YXNi/JILA_eEDM_Magnetometer/Appendix_assemble/BOM.pdf

Description | QTY | Ref Des | Mfg P/N #
CAP CER 0.22UF 25V 10% X7R 0805 | | 1 C3 | VJ0805Y224KNXAT
CAP CER 0.1UF 50V 10% X7R 0805 | | 1 C2 | VJ0805Y104KNAAT
CAP CER 0.47UF 25V 20% Y5V 0805 | | 1 C1 | VJ0805V474MXXCW1BC
IC COMPASS 3 AXIS I2C 16LCC SMD | | 1 MAG1 | HMC5883L-TR

Distributor | Distributor P/N #
Digi-key | 720-1247-2-ND
Digi-key | 720-1245-2-ND
Digi-key | 720-1389-1-ND
Digi-key | 342-1082-1-ND
