YXNi/JILA_eEDM_Magnetometer/Appendix_hardware/MagPCB/MagPCB/SensorPCB/BOM.xlsx

Best Practice Bill of Materials (BOM) Template
1. Reference Designators - Place all designators with the same part number in one cell
2. Description Value Package - Advanced Assembly's system perfers this to be combined into one cell
3. Alternate Part Numbers - Place in additional columns to the right on the same line
4. Do Not Install (DNI) Parts - Indicate quantity zero and/or add DNI column
5. Notes - Place in additional column on the same line
6. Refrain from using merged cells
*Please contact your account executive with any questions.*
 |  |  |  | êAuto-populates as you fill in the previous cellsê
Mfg Part # | Description | Value | Pkg | Description Value Pkg *AAPCB Format* | Ref. Des. | Qty | DNI | Notes | Mfg (Optional) | Vendor (Optional) | Vendor Part # (Optional) | Alternate Mfg Part # (Optional) | Type (Optional)
VJ0805Y224KNXAT | CAP | .22uF@25V | 805 | CAP .22uF@25V 805 | C3 | 1 |  |  | Vishay
VJ0805Y104KNAAT | CAP | 0.1UF 25V 10% | 805 | CAP 0.1UF 25V 10% 805 | C2 | 1 |  |  | Vishay
HMC5883L-TR | Magnetic censor |  | 16LCC SMD | Magnetic censor 16LCC SMD | MAG1 | 1 |  |  | Honeywell | Digi-Key | 342-1082-1-ND
UMK325F475ZH-T | CAP | 4.7uF@50V 10% | 1210 | CAP 4.7uF@50V 10% 1210 | C1 | 1 |  |  | Taiyo-yuden | Digi-Key | 587-1389-1-ND
