YXNi/JILA_eEDM_Magnetometer/Appendix_assemble/CPL.pdf

Ref Designator | Mid X(mm) Mid Y(mm) Layer Rotation
C1 | 0 | 12 top | 0
C2 | -5 | 12 top | 180
C3 | 5 | 12 top | 0
MAG1 | 0 | 0 top | 0
