YXNi/JILA_eEDM_Magnetometer/Appendix_hardware/MagPCB_ChipMount.pdf

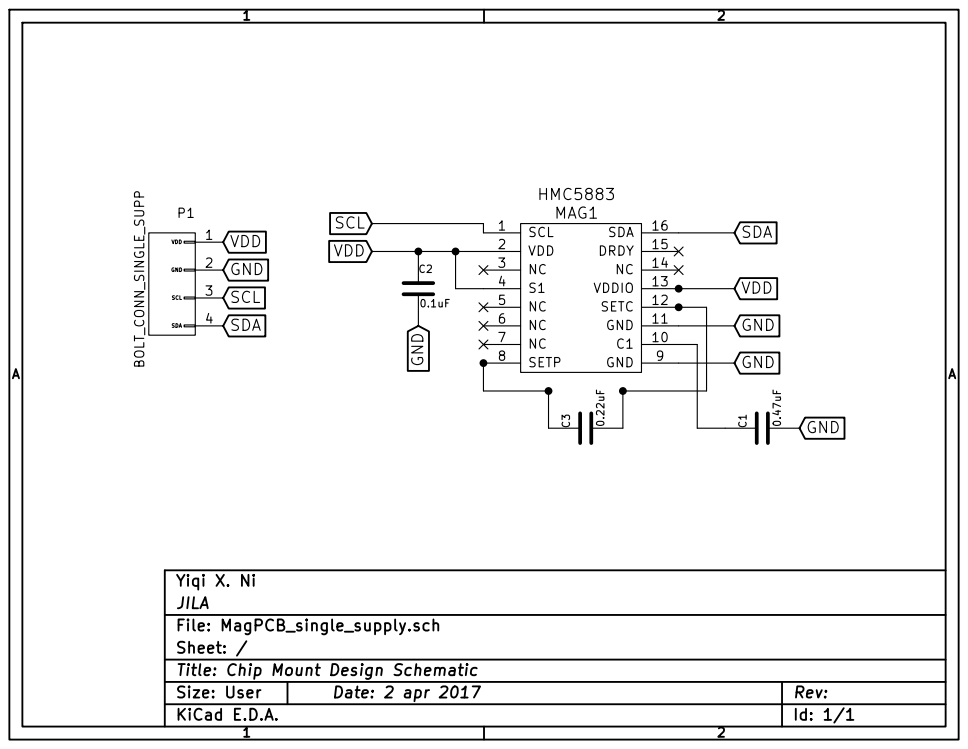
[picture p4: page 1]

Title: Chip Mount Design Schematic

Size: User | | Rev:
KiCad E.D.A. | | Id: 1/1
