YXNi/JILA_eEDM_Magnetometer/Appendix_hardware/MagPCB_Gradiometer.pdf

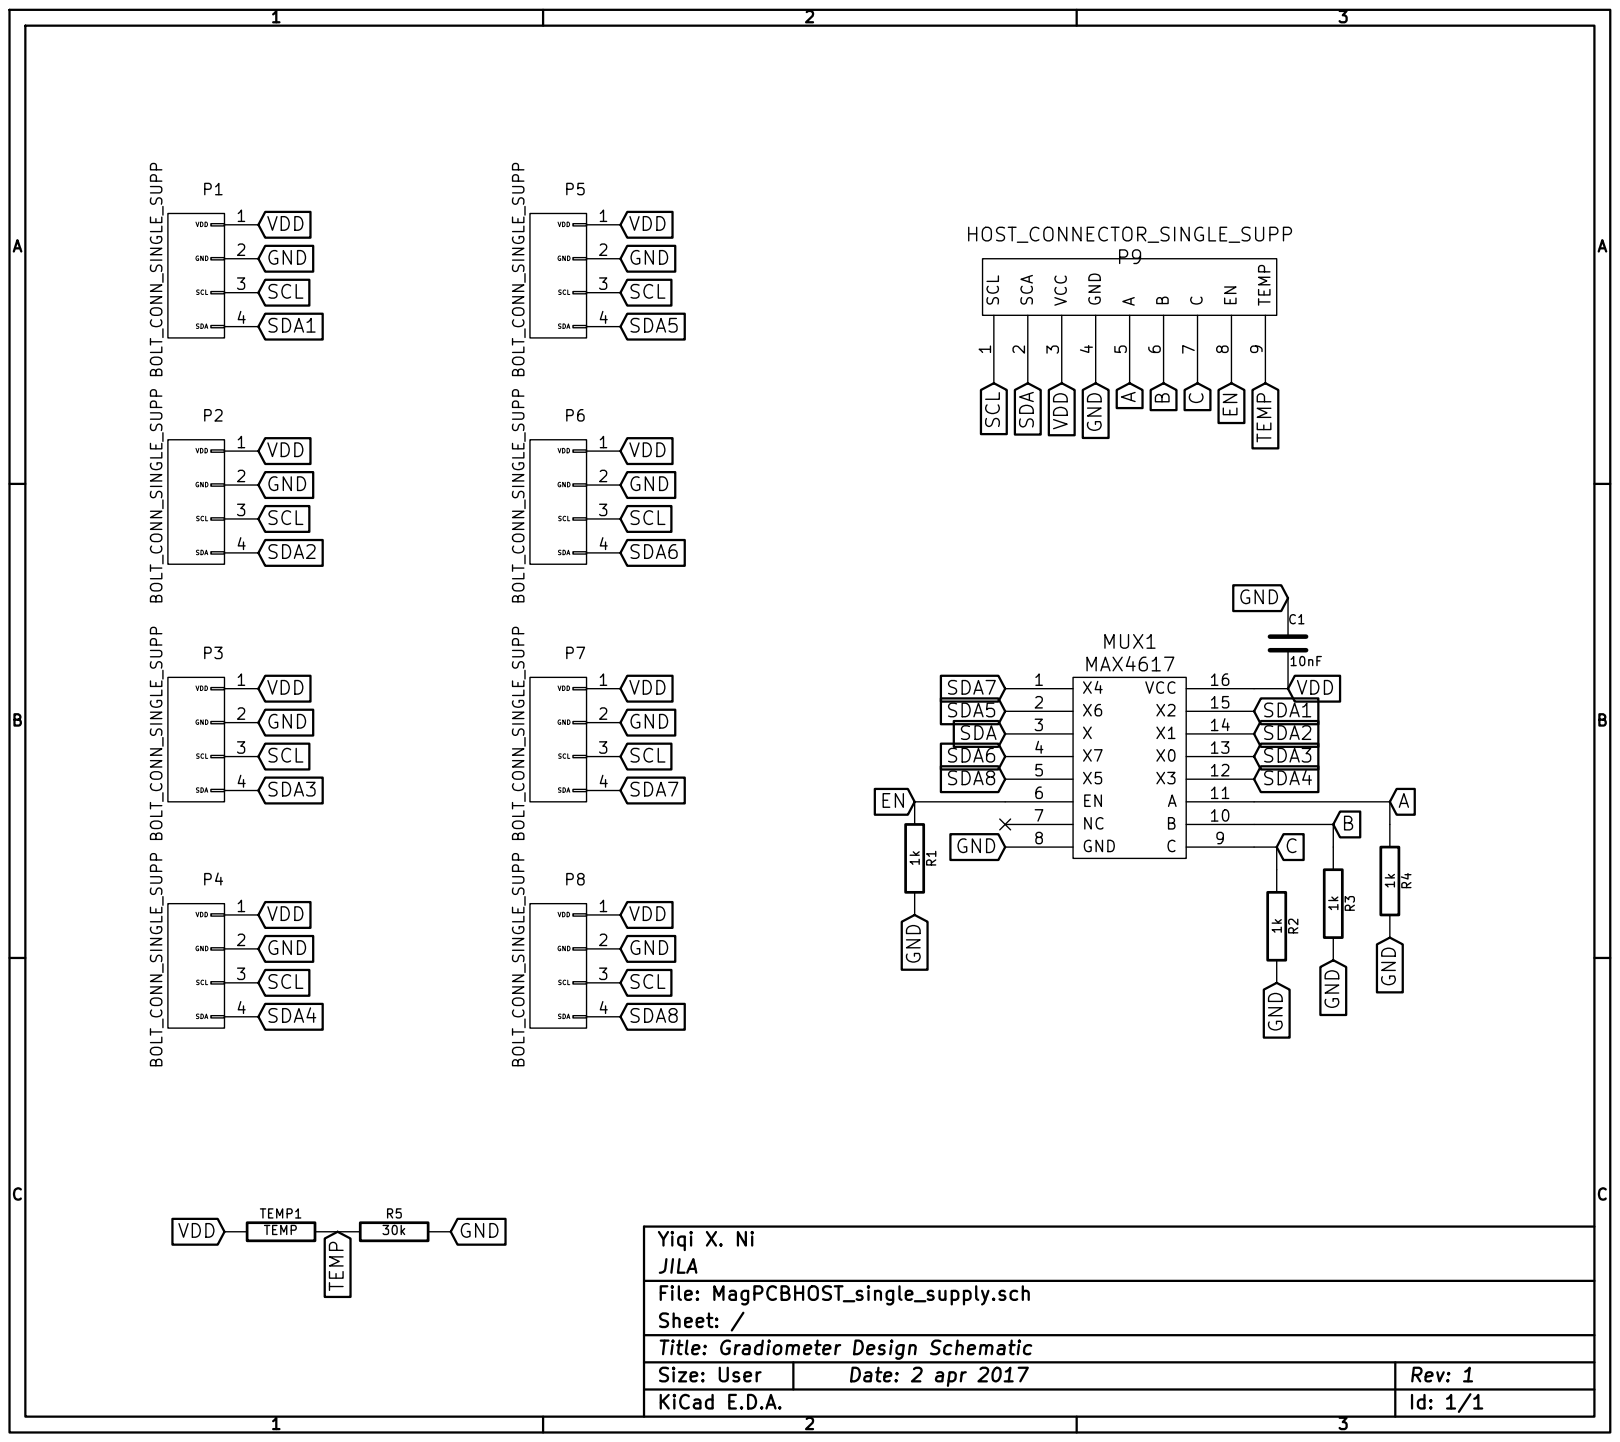
[picture p5: page 1]

Title: Gradiometer Design Schematic

Size: User | | Rev: 1
KiCad E.D.A. | | Id: 1/1
