YXNi/JILA_eEDM_Magnetometer/Appendix_hardware/MagPCB_Shield_MaggieShield.pdf

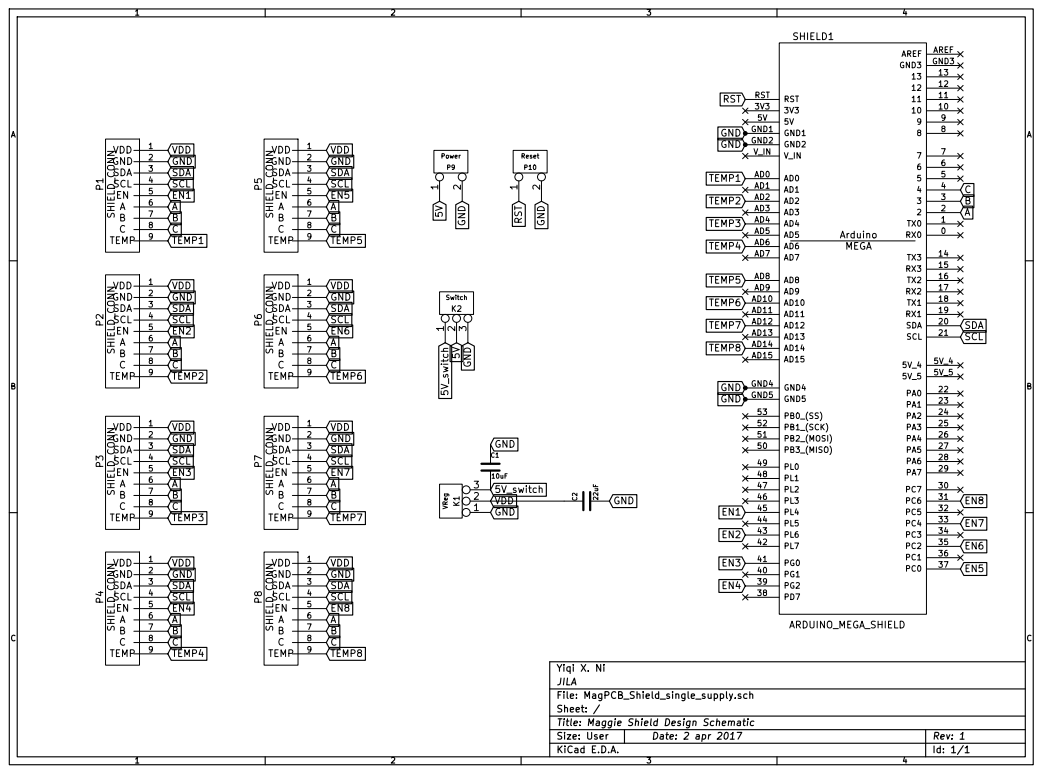
[picture p6: page 1]

Title: Maggie Shield Design Schematic

Size: User | | Rev: 1
KiCad E.D.A. | | Id: 1/1
