YXNi/JILA_eEDM_Magnetometer/Appendix_assemble/AC_spec.pdf

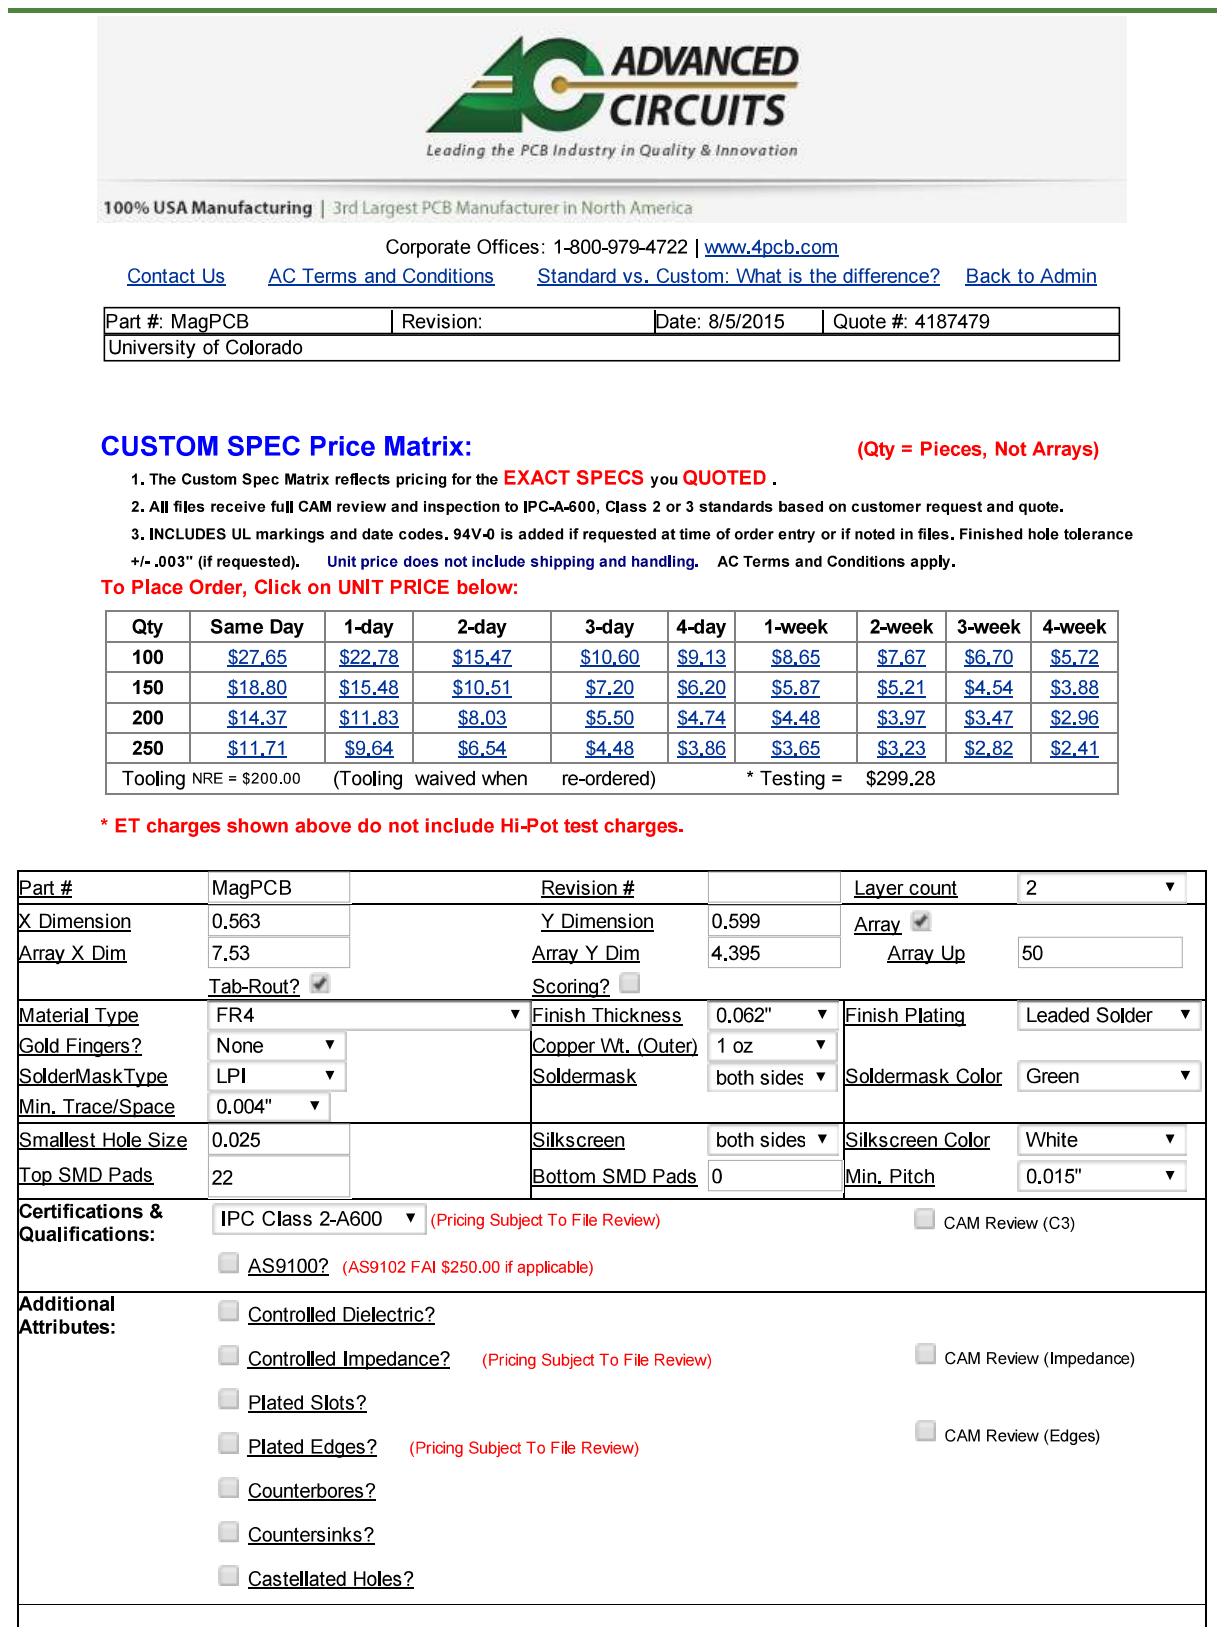
[picture p7: page 1]

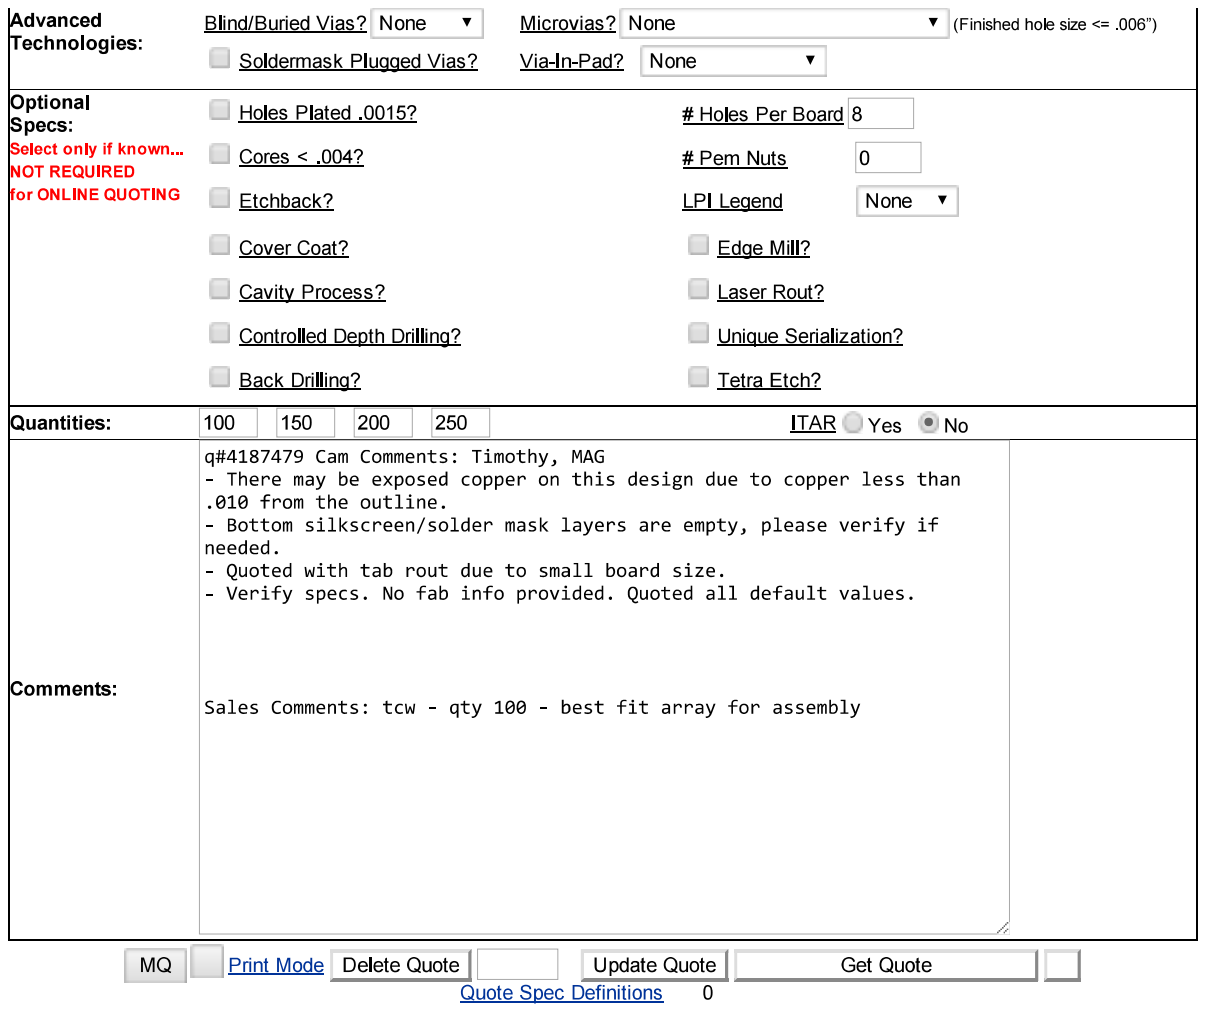
[picture p8: page 2]
