YXNi/JILA_eEDM_Magnetometer/Appendix_hardware/MagPCB/MagPCB/CalibrationMount/MagPCB_Calibration_Mount.kicad_pcb

## KiCad design Appendix_hardware/MagPCB/MagPCB/CalibrationMount/MagPCB_Calibration_Mount.kicad_pcb (2017-04-03)

Schematic: MagPCB_Calibration_Mount.sch

Parts:
HCONN1: HOST_CONN
P1: BOLT_CONN_SINGLE_SUPP
R1: Thermistor
R2: 30k

Connections:
AIN: HCONN1.5 (AIN), R1.2, R2.1
GND: HCONN1.2 (GND), P1.2, R2.2
SCL: HCONN1.3 (SCL), P1.3
SDA: HCONN1.4 (SDA), P1.4
VDD: HCONN1.1 (VDD), P1.1, R1.1

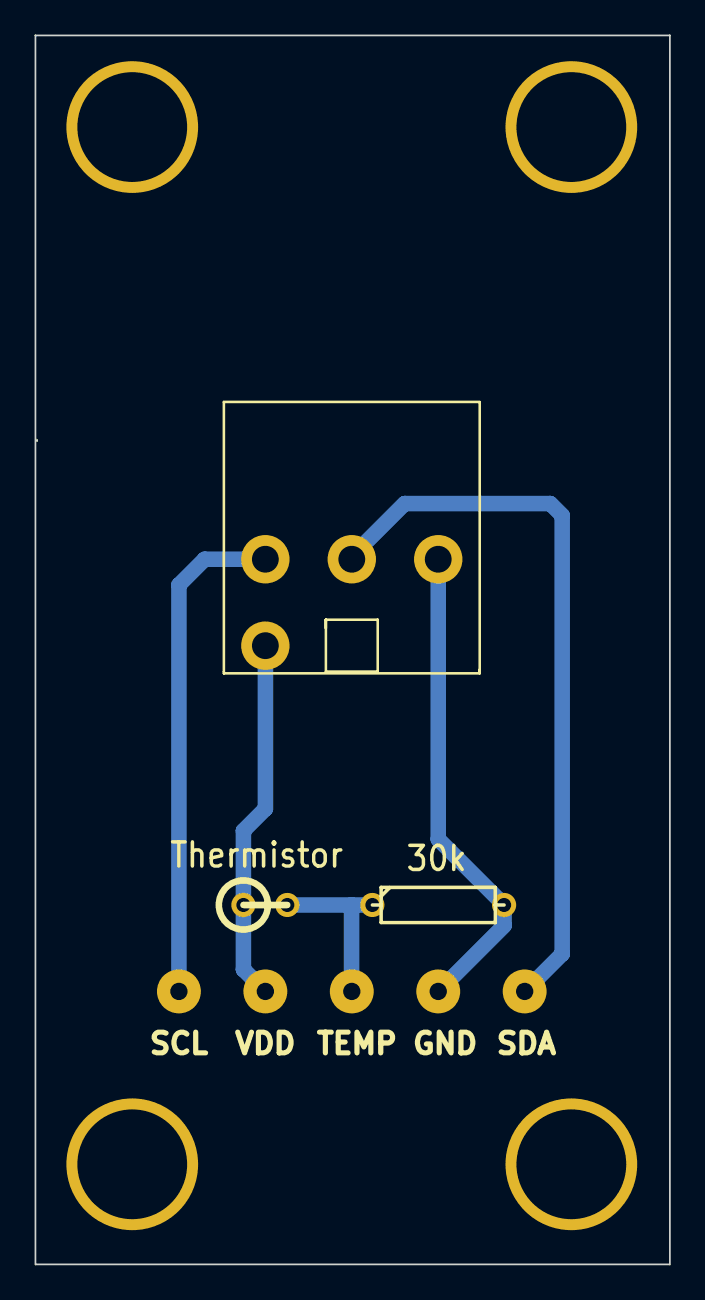
[picture p9: board MagPCB_Calibration_Mount.kicad_pcb from above]

Board: 2 copper layers, 36.7 x 71.1 mm, 6 parts (0 on the bottom side), 5 nets.

Other parts of the board:
CALIB_MOUNT_HOLES: VAL**; CALIB_MOUNT_HOLES
CALIB_MOUNT_HOLES#2: VAL**; CALIB_MOUNT_HOLES
