YXNi/JILA_eEDM_Magnetometer/Appendix_hardware/MagPCB/MagPCB/dueshield/MagPCB_Shield_single_supply.kicad_pcb

## KiCad design Appendix_hardware/MagPCB/MagPCB/dueshield/MagPCB_Shield_single_supply.kicad_pcb (2017-04-03)

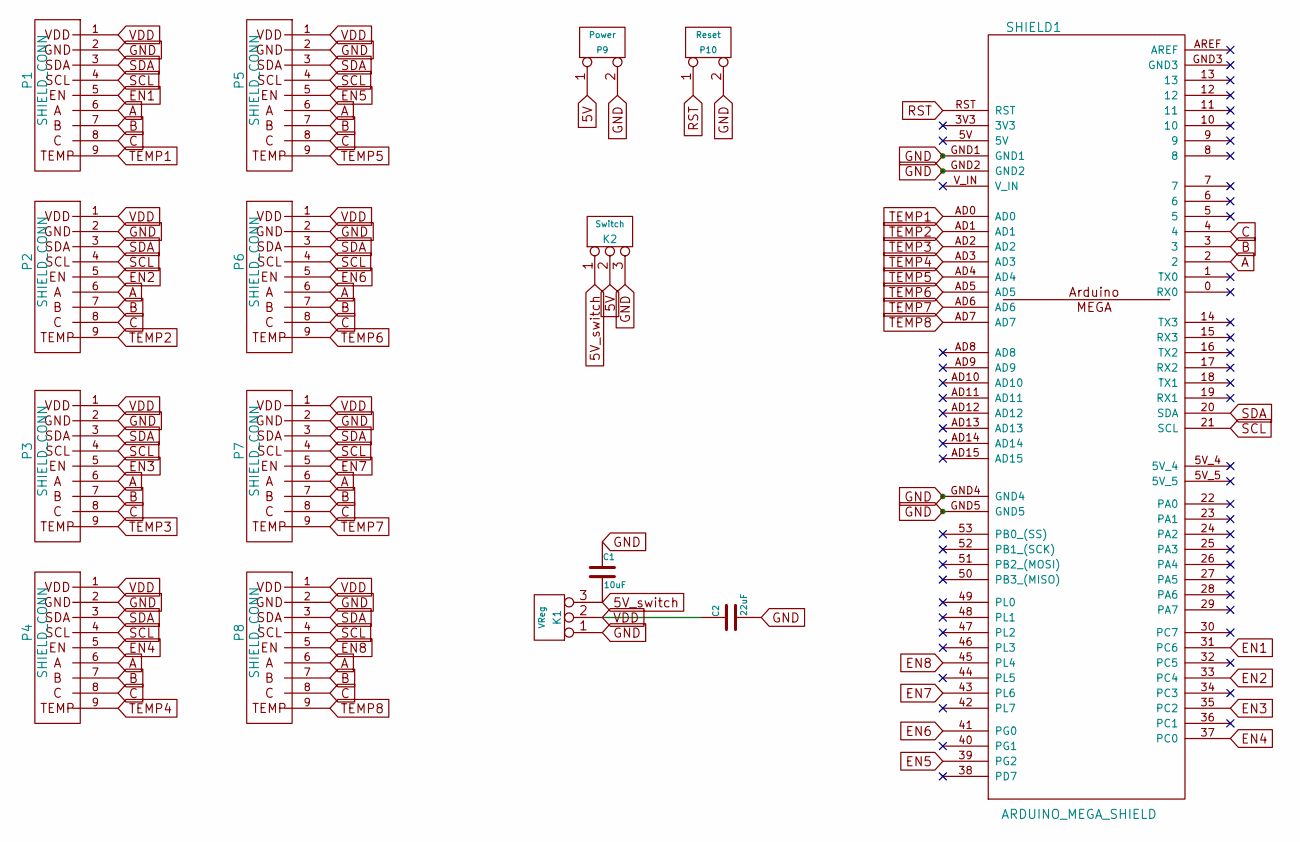
[picture p10: schematic MagPCB_Shield_single_supply.sch]

Parts:
C1: 10uF
C2: 22uF
K1: VReg
K2: Switch
P1, P2, P3, P4, P5, P6, P7, P8: SHIELD_CONN
P9: Power
P10: Reset
SHIELD1: ARDUINO_MEGA_SHIELD

Connections:
5V: K2.2 (PM), P9.1
5V_switch: C1.2, K1.3, K2.1
A: P1.6 (A), P2.6 (A), P3.6 (A), P4.6 (A), P5.6 (A), P6.6 (A), P7.6 (A), P8.6 (A), SHIELD1.2
B: P1.7 (B), P2.7 (B), P3.7 (B), P4.7 (B), P5.7 (B), P6.7 (B), P7.7 (B), P8.7 (B), SHIELD1.3
C: P1.8 (C), P2.8 (C), P3.8 (C), P4.8 (C), P5.8 (C), P6.8 (C), P7.8 (C), P8.8 (C), SHIELD1.4
EN1: P1.5 (EN), SHIELD1.31 (PC6)
EN2: P2.5 (EN), SHIELD1.33 (PC4)
EN3: P3.5 (EN), SHIELD1.35 (PC2)
EN4: P4.5 (EN), SHIELD1.37 (PC0)
EN5: P5.5 (EN), SHIELD1.39 (PG2)
EN6: P6.5 (EN), SHIELD1.41 (PG0)
EN7: P7.5 (EN), SHIELD1.43 (PL6)
EN8: P8.5 (EN), SHIELD1.45 (PL4)
GND: C1.1, C2.2, K1.1, K2.3, P1.2 (GND), P2.2 (GND), P3.2 (GND), P4.2 (GND), P5.2 (GND), P6.2 (GND), P7.2 (GND), P8.2 (GND), P9.2 (PM), P10.2 (PM), SHIELD1.GND1, SHIELD1.GND2, SHIELD1.GND4, SHIELD1.GND5
RST: P10.1, SHIELD1.RST
SCL: P1.4 (SCL), P2.4 (SCL), P3.4 (SCL), P4.4 (SCL), P5.4 (SCL), P6.4 (SCL), P7.4 (SCL), P8.4 (SCL), SHIELD1.21 (SCL)
SDA: P1.3 (SDA), P2.3 (SDA), P3.3 (SDA), P4.3 (SDA), P5.3 (SDA), P6.3 (SDA), P7.3 (SDA), P8.3 (SDA), SHIELD1.20 (SDA)
TEMP1: P1.9 (TEMP), SHIELD1.AD0
TEMP2: P2.9 (TEMP), SHIELD1.AD1
TEMP3: P3.9 (TEMP), SHIELD1.AD2
TEMP4: P4.9 (TEMP), SHIELD1.AD3
TEMP5: P5.9 (TEMP), SHIELD1.AD4
TEMP6: P6.9 (TEMP), SHIELD1.AD5
TEMP7: P7.9 (TEMP), SHIELD1.AD6
TEMP8: P8.9 (TEMP), SHIELD1.AD7
VDD: C2.1, K1.2 (PM), P1.1 (VDD), P2.1 (VDD), P3.1 (VDD), P4.1 (VDD), P5.1 (VDD), P6.1 (VDD), P7.1 (VDD), P8.1 (VDD)

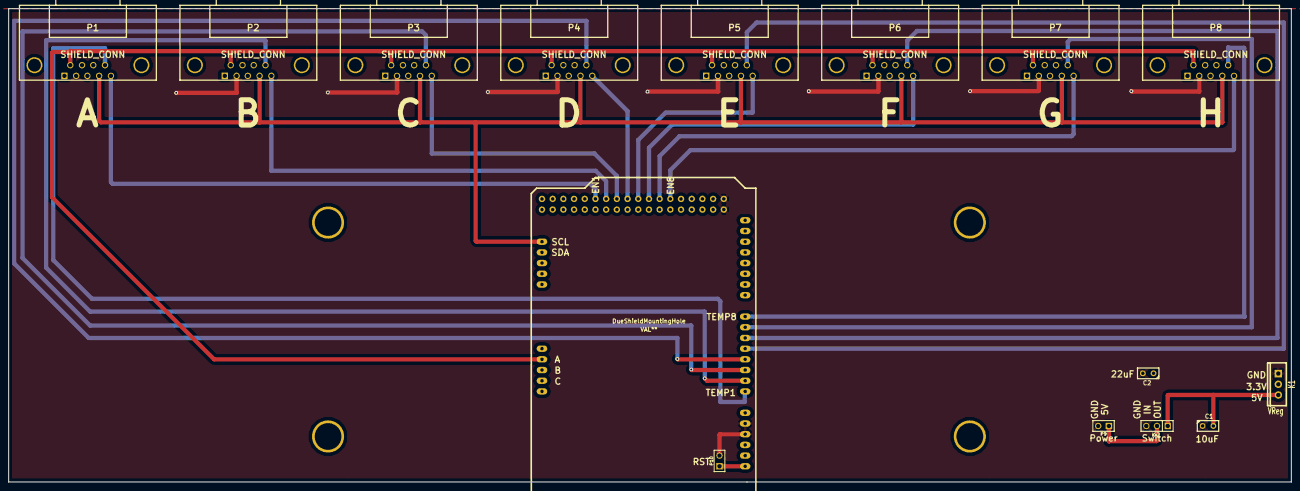
[picture p11: board MagPCB_Shield_single_supply.kicad_pcb from above]

Board: 4 copper layers, 304.6 x 112.4 mm, 16 parts (0 on the bottom side), 26 nets.

Other parts of the board:
DueShieldMountingHole: VAL**; DueShieldMountingHole
