YXNi/JILA_eEDM_Magnetometer/Appendix_hardware/MagPCB/MagPCB/SensorPCB/MagPCB_single_supply.kicad_pcb

## KiCad design Appendix_hardware/MagPCB/MagPCB/SensorPCB/MagPCB_single_supply.kicad_pcb (2017-04-03)

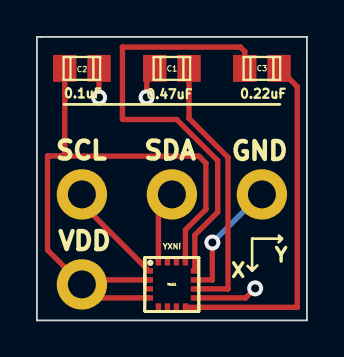
[picture p12: board MagPCB_single_supply.kicad_pcb from above]

Board: 2 copper layers, 15.0 x 15.8 mm, 4 parts (0 on the bottom side), 5 nets.

Parts:
C1, C2, C3: c_0805
MAG1: HMC5883

Connections:
GND: C1.2, C2.2, MAG1.9, MAG1.11
unnamed: C1.1, MAG1.10
unnamed: C3.2, MAG1.12
unnamed: C3.1, MAG1.8
VDD: C2.1, MAG1.2, MAG1.4, MAG1.13
