YXNi/JILA_eEDM_Magnetometer/Appendix_hardware/MagPCB/MagPCB/HostPCB/MagPCBHOST_single_supply.kicad_pcb

## KiCad design Appendix_hardware/MagPCB/MagPCB/HostPCB/MagPCBHOST_single_supply.kicad_pcb (2017-04-03)

Schematic: MagPCBHOST_single_supply.sch

Parts:
C1: 10nF
MUX1: MAX4617
P1, P2, P3, P4, P5, P6, P7, P8: BOLT_CONN_SINGLE_SUPP
P9: HOST_CONNECTOR_SINGLE_SUPP
R1, R2, R3, R4: 1k
R5: 30k
TEMP1: TEMP

Connections:
A: MUX1.11 (A), P9.5 (A), R4.1
B: MUX1.10 (B), P9.6 (B), R3.1
C: MUX1.9 (C), P9.7 (C), R2.1
EN: MUX1.6 (EN), P9.8 (EN), R1.1
GND: C1.1, MUX1.8 (GND), P1.2, P2.2, P3.2, P4.2, P5.2, P6.2, P7.2, P8.2, P9.4 (GND), R1.2, R2.2, R3.2, R4.2, R5.2
SCL: P1.3, P2.3, P3.3, P4.3, P5.3, P6.3, P7.3, P8.3, P9.1 (SCL)
SDA: MUX1.3 (X), P9.2 (SCA)
SDA1: MUX1.15 (X2), P1.4
SDA2: MUX1.14 (X1), P2.4
SDA3: MUX1.13 (X0), P3.4
SDA4: MUX1.12 (X3), P4.4
SDA5: MUX1.2 (X6), P5.4
SDA6: MUX1.4 (X7), P6.4
SDA7: MUX1.1 (X4), P7.4
SDA8: MUX1.5 (X5), P8.4
TEMP: P9.9 (TEMP), R5.1, TEMP1.2
VDD: C1.2, MUX1.16 (VCC), P1.1, P2.1, P3.1, P4.1, P5.1, P6.1, P7.1, P8.1, P9.3 (VCC), TEMP1.1

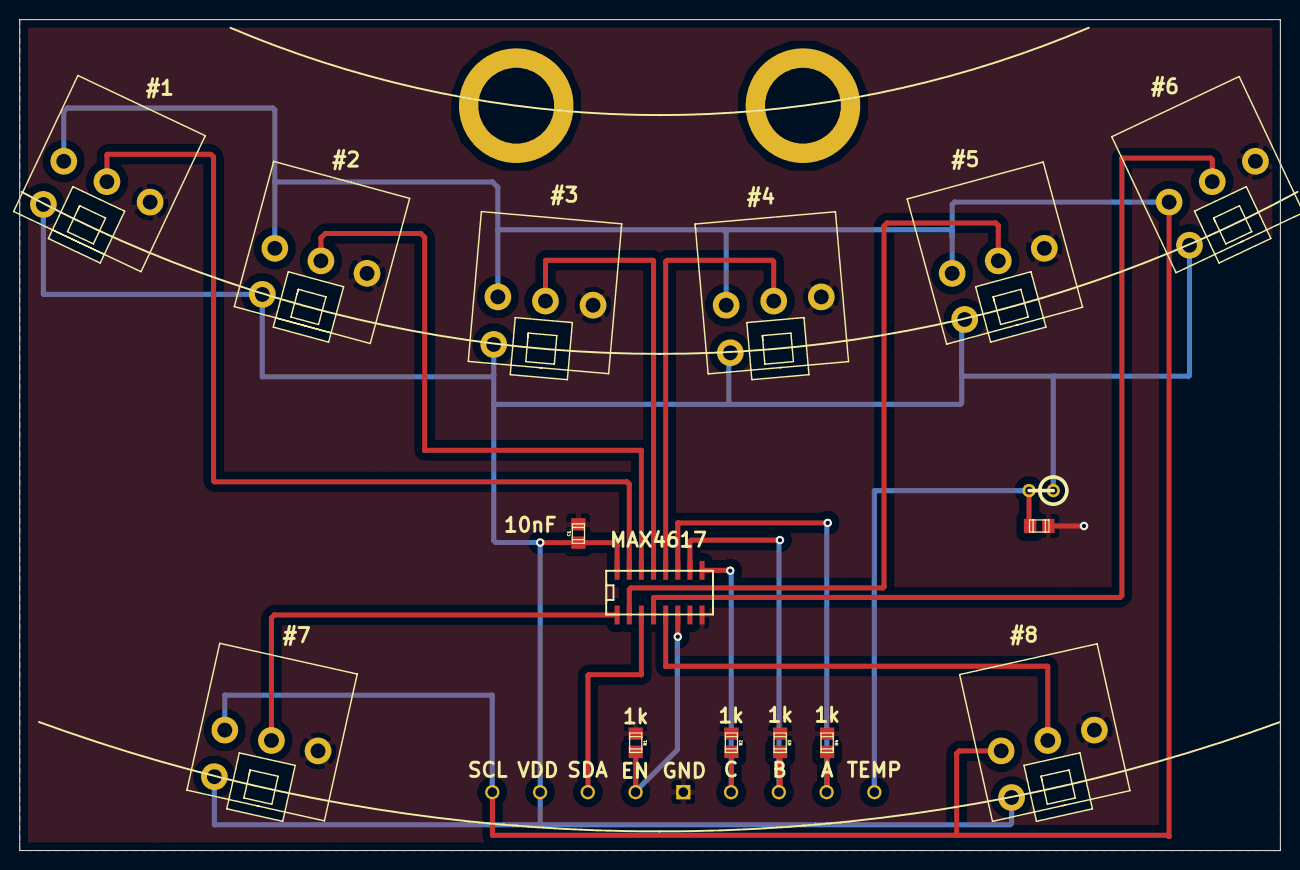
[picture p13: board MagPCBHOST_single_supply.kicad_pcb from above]

Board: 2 copper layers, 132.0 x 87.0 mm, 17 parts (0 on the bottom side), 17 nets.
