YXNi/JILA_eEDM_Magnetometer/Appendix_hardware/MagPCB/MagPCB/VacuumGradiometer/VacuumGradiometer.kicad_pcb

## KiCad design Appendix_hardware/MagPCB/MagPCB/VacuumGradiometer/VacuumGradiometer.kicad_pcb (2017-04-03)

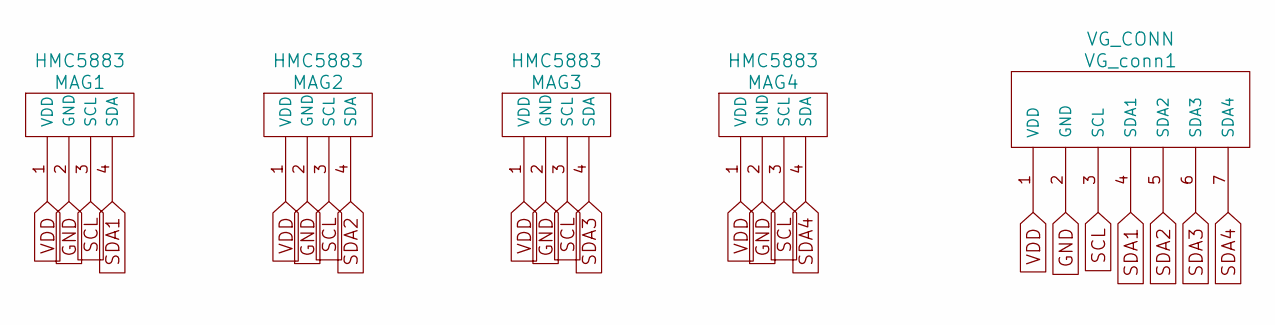
[picture p14: schematic VacuumGradiometer.sch]

Parts:
MAG1, MAG2, MAG3, MAG4: HMC5883
VG_conn1: VG_CONN

Connections:
GND: MAG1.2 (GND), MAG2.2 (GND), MAG3.2 (GND), MAG4.2 (GND), VG_conn1.2 (GND)
SCL: MAG1.3 (SCL), MAG2.3 (SCL), MAG3.3 (SCL), MAG4.3 (SCL), VG_conn1.3 (SCL)
SDA1: MAG1.4 (SDA), VG_conn1.4 (SDA1)
SDA2: MAG2.4 (SDA), VG_conn1.5 (SDA2)
SDA3: MAG3.4 (SDA), VG_conn1.6 (SDA3)
SDA4: MAG4.4 (SDA), VG_conn1.7 (SDA4)
VDD: MAG1.1 (VDD), MAG2.1 (VDD), MAG3.1 (VDD), MAG4.1 (VDD), VG_conn1.1 (VDD)

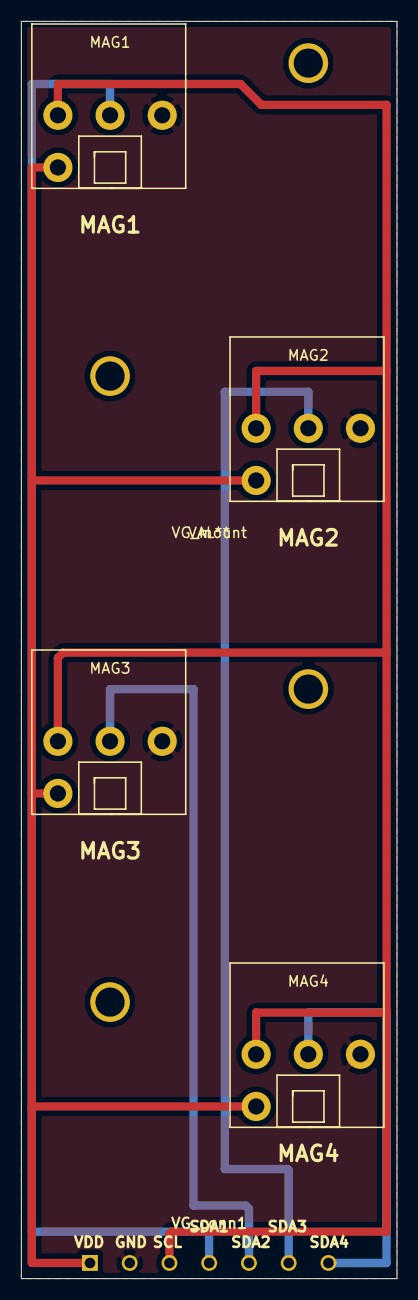
[picture p15: board VacuumGradiometer.kicad_pcb from above]

Board: 2 copper layers, 36.0 x 120.5 mm, 6 parts (0 on the bottom side), 7 nets.

Other parts of the board:
VG_mount: VAL**; VG_mount
