YXNi/JILA_eEDM_Magnetometer/Appendix_software/MagLibrary/MagLibrary/MagLibrary.h

/***************************************************************************
  This is a library for the HMC5883 magnentometer/compass

  Designed specifically to work with the Adafruit HMC5883 Breakout
  http://www.adafruit.com/products/1746

  These displays use I2C to communicate, 2 pins are required to interface.

  Adafruit invests time and resources providing this open source code,
  please support Adafruit andopen-source hardware by purchasing products
  from Adafruit!

  Written by Kevin Townsend for Adafruit Industries.
  BSD license, all text above must be included in any redistribution
 ***************************************************************************/

 /************************************************************
 This library is based on original communication protocol of Honeywell HMC5883
 and open source of Adafuit breakout board library.
 
 Modification was made by YXNi for JILA eEDM experiment.
 ************************************************************/

#ifndef __HMC5883_H__
#define __HMC5883_H__
#include "Arduino.h"
#include <Wire.h>

/*=========================================================================
    I2C ADDRESS/BITS
    -----------------------------------------------------------------------*/
    #define HMC5883_ADDRESS_MAG            (0x3C >> 1)         // 0011110x
/*=========================================================================*/

/*=========================================================================
    REGISTERS
    -----------------------------------------------------------------------*/
    typedef enum
    {
      HMC5883_REGISTER_MAG_CRA_REG_M             = 0x00,
      HMC5883_REGISTER_MAG_CRB_REG_M             = 0x01,
      HMC5883_REGISTER_MAG_MR_REG_M              = 0x02,
      HMC5883_REGISTER_MAG_OUT_X_H_M             = 0x03,
      HMC5883_REGISTER_MAG_OUT_X_L_M             = 0x04,
      HMC5883_REGISTER_MAG_OUT_Z_H_M             = 0x05,
      HMC5883_REGISTER_MAG_OUT_Z_L_M             = 0x06,
      HMC5883_REGISTER_MAG_OUT_Y_H_M             = 0x07,
      HMC5883_REGISTER_MAG_OUT_Y_L_M             = 0x08,
      HMC5883_REGISTER_MAG_SR_REG_Mg             = 0x09,
      HMC5883_REGISTER_MAG_IRA_REG_M             = 0x0A,
      HMC5883_REGISTER_MAG_IRB_REG_M             = 0x0B,
      HMC5883_REGISTER_MAG_IRC_REG_M             = 0x0C,
      HMC5883_REGISTER_MAG_TEMP_OUT_H_M          = 0x31,
      HMC5883_REGISTER_MAG_TEMP_OUT_L_M          = 0x32
    } hmc5883MagRegisters_t;
/*=========================================================================*/

/*=========================================================================
    MAGNETOMETER GAIN SETTINGS
    -----------------------------------------------------------------------*/
    typedef enum
    {
      HMC5883_MAGGAIN_1_3                        = 0x20,  // +/- 1.3
      HMC5883_MAGGAIN_1_9                        = 0x40,  // +/- 1.9
      HMC5883_MAGGAIN_2_5                        = 0x60,  // +/- 2.5
      HMC5883_MAGGAIN_4_0                        = 0x80,  // +/- 4.0
      HMC5883_MAGGAIN_4_7                        = 0xA0,  // +/- 4.7
      HMC5883_MAGGAIN_5_6                        = 0xC0,  // +/- 5.6
      HMC5883_MAGGAIN_8_1                        = 0xE0   // +/- 8.1
    } hmc5883MagGain;
/*=========================================================================*/

	typedef struct {
		float x;
		float y;
		float z;    
	} magvec;

/* Unified sensor driver for the magnetometer */
class MagLibrary  //public Adafruit_Sensor
{
  public:
    MagLibrary();
    void begin(magvec*);
    void setMagGain(hmc5883MagGain gain);
    void getEvent(magvec*);
	  void setStrap(bool);
	  void cancelStrap(void);
	  void dGauss(int strapCounts);
    void getStrap(magvec*);
    void checkState(void);
    bool state;

  private:
    hmc5883MagGain   _magGain;
    magvec		     _magData;     // Last read magnetometer data will be available here

	  unsigned t1; //time counters
	  unsigned t2;
	  int lp;//the registered loops

    void write8(byte address, byte reg, byte value);
    byte read8(byte address, byte reg);
    void read(void);
};

#endif
